Aykut0/ultrasonic-theremin/mechanical/theremin-lower-tray-FIT-PROTOTYPE.stl

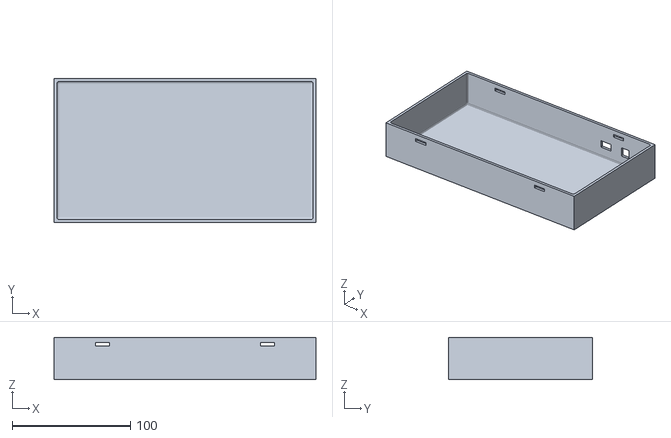
[picture p20: CAD file, 2026-11-11]
mechanical/theremin-lower-tray-FIT-PROTOTYPE.stl
222.0 x 122.0 x 36.0
