Aykut0/ultrasonic-theremin/mechanical/theremin-top-panel-FIT-PROTOTYPE.stl

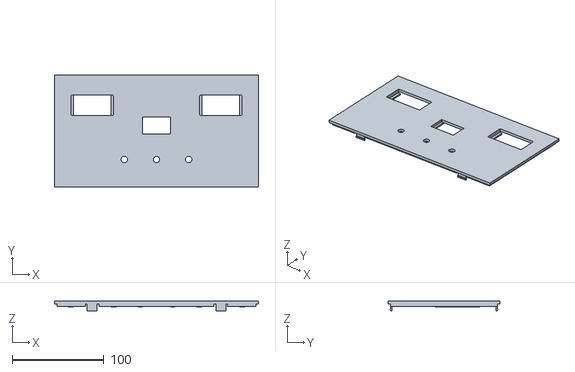
[picture p21: CAD file, 2026-11-11]
mechanical/theremin-top-panel-FIT-PROTOTYPE.stl
222.0 x 122.0 x 10.5
