Aykut0/ultrasonic-theremin/(list of files, cad)

Other CAD files:
mechanical/theremin-enclosure.blend
